maximaas/VideoGame-DIY/md/ccam/ccam.brd

## EAGLE design md/ccam/ccam.brd (2019-10-08)

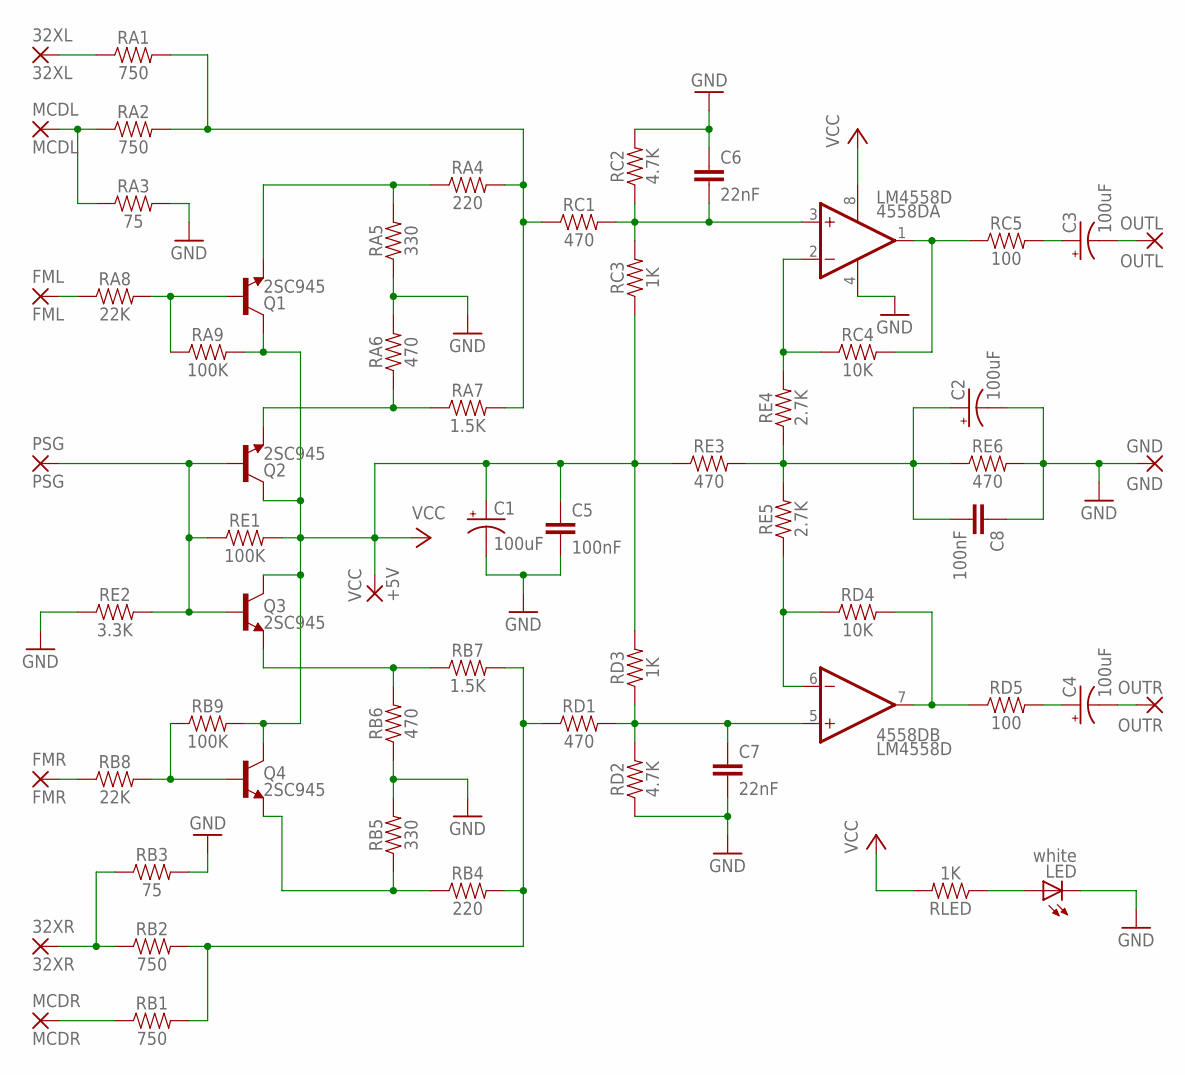
[picture p5: schematic ccam.sch]

Parts:
32XL: 32XL; SMD1,27-2,54
32XR: 32XR; SMD1,27-2,54
4558D: LM4558D; SO08
C1, C2, C3, C4: 100uF; EIA6032-NOM
C5, C8: 100nF; 0805
C6, C7: 22nF; 0805
FML: FML; SMD1,27-2,54
FMR: FMR; SMD1,27-2,54
GND: GND; SMD1,27-2,54
LED: white; CHIP-LED0805
MCDL: MCDL; SMD1,27-2,54
MCDR: MCDR; SMD1,27-2,54
OUTL: OUTL; SMD1,27-2,54
OUTR: OUTR; SMD1,27-2,54
PSG: PSG; SMD1,27-2,54
Q1, Q2, Q3, Q4: 2SC945; SOT23-3
RA1, RA2: 750; 0805
RA3: 75; 0805
RA4: 220; 0805
RA5: 330; 0805
RA6: 470; 0805
RA7: 1.5K; 0805
RA8: 22K; 0805
RA9: 100K; 0805
RB1, RB2: 750; 0805
RB3: 75; 0805
RB4: 220; 0805
RB5: 330; 0805
RB6: 470; 0805
RB7: 1.5K; 0805
RB8: 22K; 0805
RB9: 100K; 0805
RC1: 470; 0805
RC2: 4.7K; 0805
RC3: 1K; 0805
RC4: 10K; 0805
RC5: 100; 0805
RD1: 470; 0805
RD2: 4.7K; 0805
RD3: 1K; 0805
RD4: 10K; 0805
RD5: 100; 0805
RE1: 100K; 0805
RE2: 3.3K; 0805
RE3, RE6: 470; 0805
RE4, RE5: 2.7K; 0805
RLED: 1K; 0805
VCC: +5V; SMD1,27-2,54

Connections:
GND: 4558D.4 (V-), C1.C (-), C2.C (-), C5.2, C6.1, C7.2, C8.1, GND.1, LED.C, RA3.2, RA5.1, RA6.2, RB3.2, RB5.2, RB6.1, RC2.2, RD2.1, RE2.1, RE6.2
unnamed: 32XL.1, RA1.1
unnamed: MCDL.1, RA2.1, RA3.1
unnamed: RA1.2, RA2.2, RA4.2, RA7.2, RC1.1
unnamed: FML.1, RA8.1
unnamed: Q1.1 (B), RA8.2, RA9.1
unnamed: Q4.1 (B), RB8.2, RB9.1
unnamed: PSG.1, Q2.1 (B), Q3.1 (B), RE1.1, RE2.2
unnamed: Q1.2 (E), RA4.1, RA5.2
unnamed: FMR.1, RB8.1
unnamed: Q2.2 (E), RA6.1, RA7.1
unnamed: MCDR.1, RB1.1
unnamed: 32XR.1, RB2.1, RB3.1
unnamed: RB1.2, RB2.2, RB4.2, RB7.2, RD1.1
unnamed: Q3.2 (E), RB6.2, RB7.1
unnamed: 4558D.3 (+IN), C6.2, RC1.2, RC2.1, RC3.2
unnamed: Q4.2 (E), RB4.1, RB5.1
unnamed: 4558D.5 (+IN), C7.1, RD1.2, RD2.2, RD3.1
unnamed: 4558D.2 (-IN), RC4.1, RE4.2
unnamed: C2.A (+), C8.2, RE3.2, RE4.1, RE5.2, RE6.1
unnamed: C4.A (+), RD5.2
unnamed: 4558D.1 (OUT), RC4.2, RC5.1
unnamed: C3.A (+), RC5.2
unnamed: C3.C (-), OUTL.1
unnamed: C4.C (-), OUTR.1
unnamed: LED.A, RLED.1
unnamed: 4558D.7 (OUT), RD4.2, RD5.1
unnamed: 4558D.6 (-IN), RD4.1, RE5.1
VCC: 4558D.8 (V+), C1.A (+), C5.1, Q1.3 (C), Q2.3 (C), Q3.3 (C), Q4.3 (C), RA9.2, RB9.2, RC3.1, RD3.2, RE1.2, RE3.1, RLED.2, VCC.1

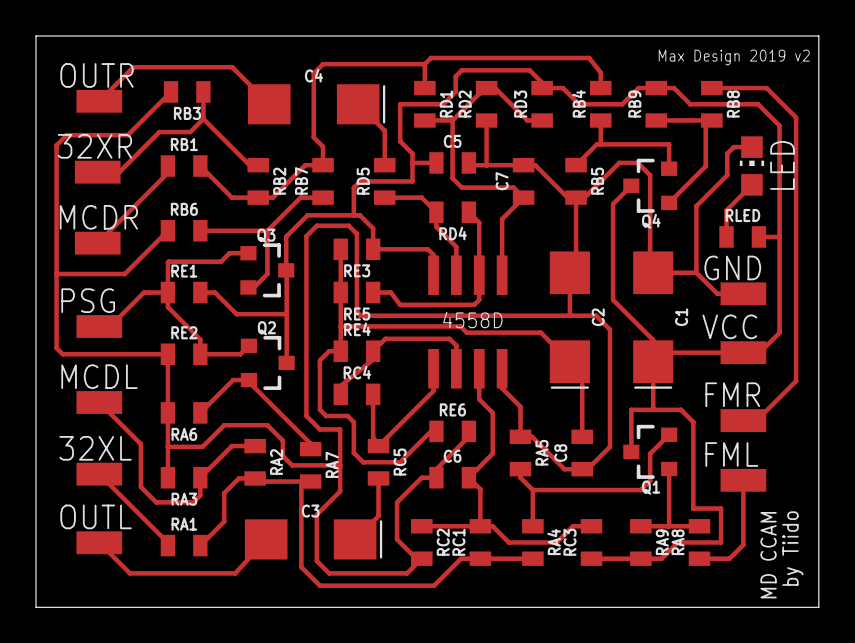
[picture p6: board ccam.brd from above]

Board: 2 copper layers, 43.5 x 31.7 mm, 60 parts (0 on the bottom side), 29 nets.
